DK0FR/Sciencedays2023/README.md

# Sciencedays2023

Project files for the Sciencedays 2023 Project: PCB Coil BLDC Motor.
