DK0FR/Sciencedays2023/PCBMotorV3/production_files/BOM.xlsx

Designator | Footprint | Quantity | Value | LCSC Part #
C10, C11, C12, C50, C6, C8, C9 | 0603 | 8 | 100n | C14663
J2 | USB_C_C2927293 | 1 |  | C2927293
Q10, Q11, Q13 | SOT-23 | 3 | AO3401A | C15127
R10, R100, R101, R102, R103, R104, R105, R11, R12, R13, R50 | 0603 | 9 | 10k | C25804
U2 | SSOP-10_3.9x4.9mm_P1.00mm_EP3x3mm | 1 | CH224K | C970725
U3 | LQFP-48_7x7mm_P0.5mm | 1 | STM32G030C8Tx | C529329
U5, U6, U7 | SOT-23W | 3 | CH941SR | C455292
D1, D2, D3 | LED_ASMB-KTF0-0A306 | 3 |  | C2874116
D4 | SOD123-W | 1 | B5819W SL | C8598
