DK0FR/Sciencedays2023/PCBMotorV3/production_files/BOM_Hand.xlsx

Designator | Footprint | Quantity | Value | Cost per piece | Total Cost
C1 | C_Disc_D7.5mm_W2.5mm_P5.00mm | 1 | 1u | 0.02 | 0.02 | https://de.aliexpress.com/item/1005004492291271.html?mp=1
C2, C3, C4 | C_Disc_D7.5mm_W2.5mm_P5.00mm | 3 | 10n | 0.02 | 0.06 | https://de.aliexpress.com/item/1005004492291271.html?mp=1
Q1, Q2, Q3, Q4, Q5, Q6 | TO-92 | 6 | 2N7000 | 0.04 | 0.24 | https://de.aliexpress.com/item/1005001859842797.html?curPageLogUid=THt7Ze4M6XRx
R1, R2, R3 | R_Axial_DIN0207_L6.3mm_D2.5mm_P12.5mm_Horizontal | 3 | 10k | 0.01 | 0.03 | https://de.aliexpress.com/item/1005002849812340.html?mp=1
R4, R5, R6 | R_Axial_DIN0207_L6.3mm_D2.5mm_P12.5mm_Horizontal | 3 | 5.1k | 0.01 | 0.03 | https://de.aliexpress.com/item/1005002849812340.html?mp=1
R7 | R_Axial_DIN0207_L6.3mm_D2.5mm_P12.5mm_Horizontal | 1 | 1k | 0.01 | 0.01 | https://de.aliexpress.com/item/1005002849812340.html?mp=1
U1 | TO-92 | 1 | AP7384-33V | 0.15 | 0.15 | https://de.aliexpress.com/item/1005004734295187.html?curPageLogUid=9FDWB8cPhNI2
 | Magnet | 8 |  | 0.05 | 0.4 | https://de.aliexpress.com/item/1005004052861676.html?mp=1
 | PCB Spacer | 4 |  | 0.14 | 0.56 | https://de.aliexpress.com/item/1005001458691986.html?curPageLogUid=zxzx5cIOwDQW
 |  |  |  | Total: | 1.5
