DK0FR/Sciencedays2023/CAD/Rotorv3.SLDPRT

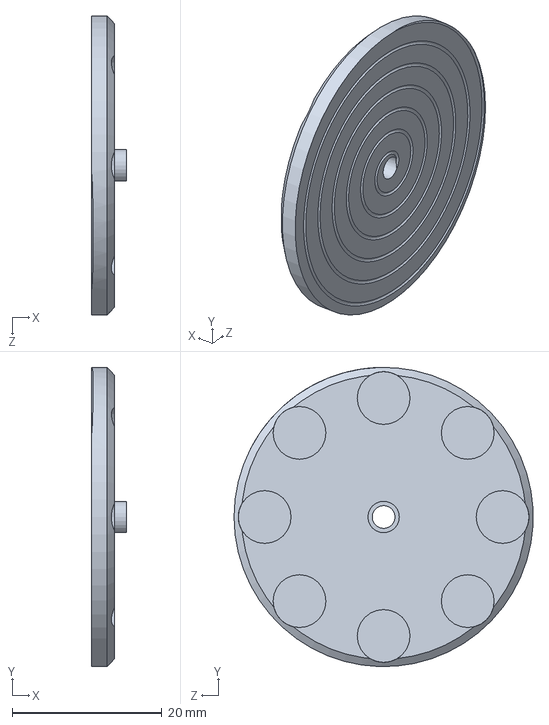
[picture p1: CAD file, 2023-10-25]
CAD/Rotorv3.SLDPRT
4.70 x 40.0 x 40.0 mm
