DK0FR/Sciencedays2023/PCBMotorV3/PCBMotorV3.step

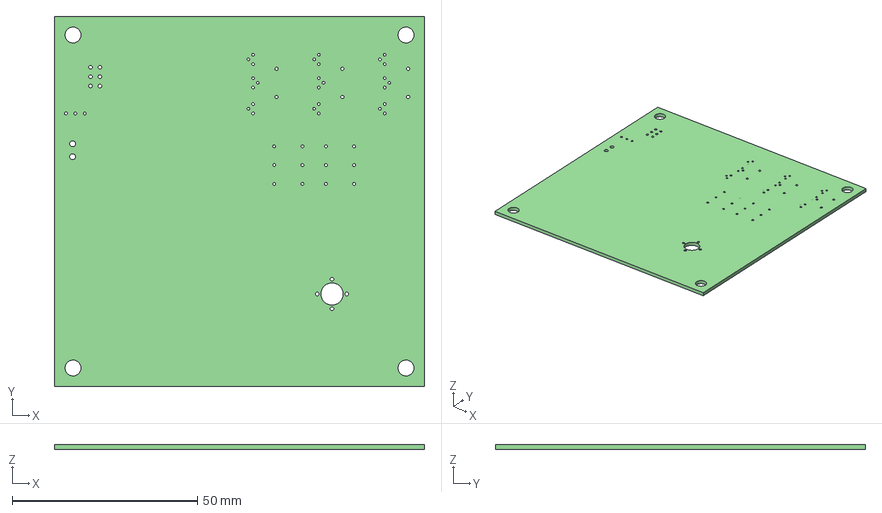
[picture p2: CAD file, 2023-10-25]
PCBMotorV3/PCBMotorV3.step
100.0 x 100.0 x 1.36 mm
