DK0FR/Sciencedays2023/CAD/KugellagerHalter.SLDPRT

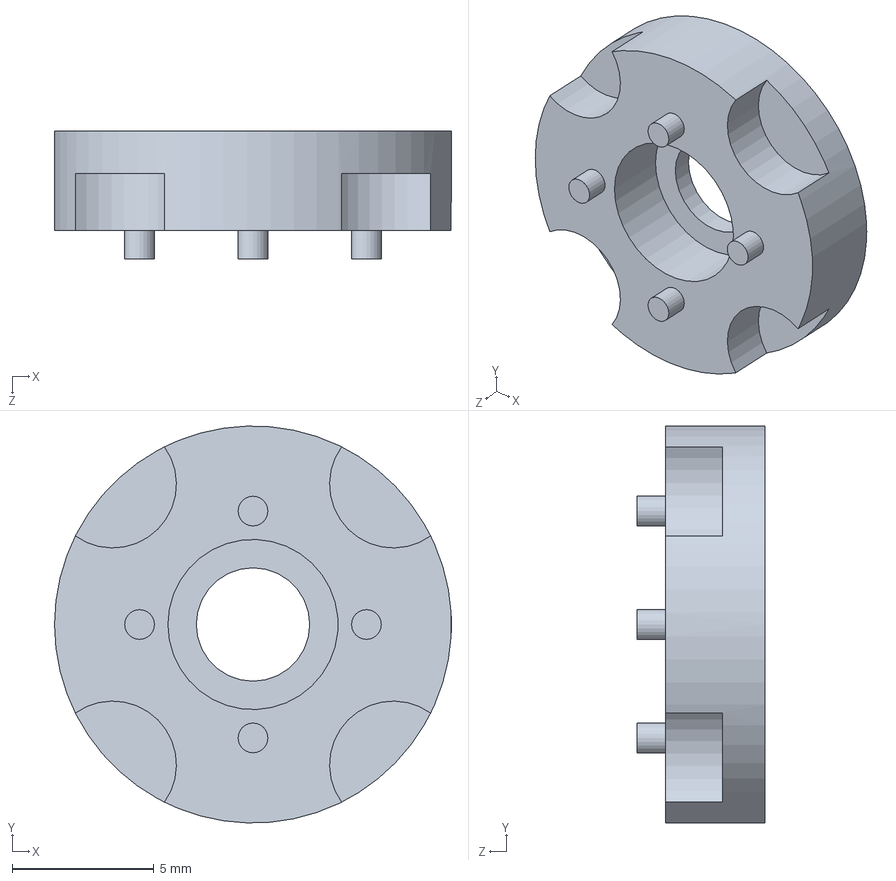
[picture p3: CAD file, 2023-10-25]
CAD/KugellagerHalter.SLDPRT
14.0 x 14.0 x 4.50 mm
