DK0FR/Sciencedays2023/(list of files, cad)

Other CAD files:
CAD/KugellagerHalter.STL
