DK0FR/Sciencedays2023/PCBMotorV3/PCBMotorV3.kicad_pcb

## KiCad design PCBMotorV3/PCBMotorV3.kicad_pcb (2023-10-25)

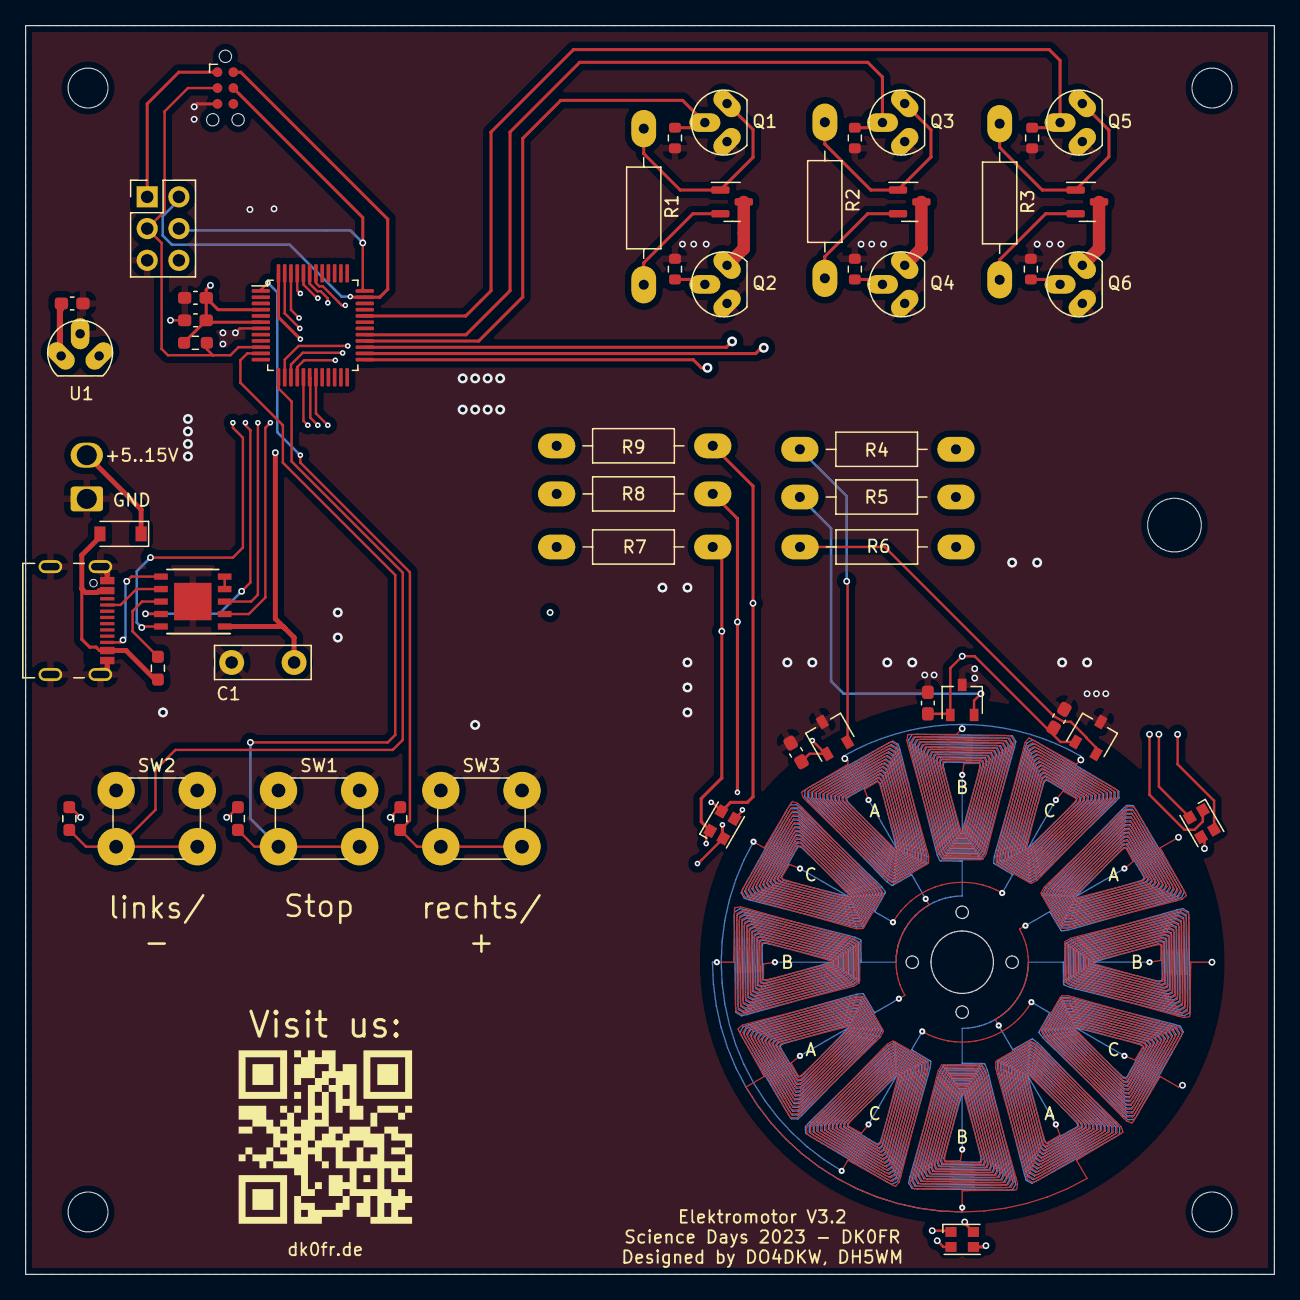
[picture p4: board PCBMotorV3.kicad_pcb from above]

Board: 4 copper layers, 100.0 x 100.0 mm, 58 parts (0 on the bottom side), 40 nets.

Parts:
C1: 1u; C_Disc_D7.5mm_W2.5mm_P5.00mm
C6, C8, C10, C11, C12, C50: 100n; C_0603_1608Metric_Pad1.08x0.95mm_HandSolder
D1, D2, D3: LED_RGBA; LED_ASMB-KTF0-0A306
D4: D; D_SOD-123
H1, H2, H3, H4: MountingHole; MountingHole_3.2mm_M3
H5: MountingHole; MountingHole_4.3mm_M4
J1: Conn_01x02; 2Pol_THT
J2: C2927293; USB_C_C2927293
J3: Conn_ARM_SWD_TagConnect_TC2030; Tag-Connect_TC2030-IDC-NL_2x03_P1.27mm_Vertical
Q1, Q2, Q3, Q4, Q5, Q6: 2N7000; TO-92
Q10, Q11, Q13: AO3401A; SOT-23
R1, R2, R3: 10k; R_Axial_DIN0207_L6.3mm_D2.5mm_P12.5mm_Horizontal
R4, R5, R6: 5.1k; R_Axial_DIN0207_L6.3mm_D2.5mm_P12.5mm_Horizontal
R7: 120; R_Axial_DIN0207_L6.3mm_D2.5mm_P12.5mm_Horizontal
R8: 56; R_Axial_DIN0207_L6.3mm_D2.5mm_P12.5mm_Horizontal
R9: 47; R_Axial_DIN0207_L6.3mm_D2.5mm_P12.5mm_Horizontal
R10, R11, R12, R13, R50: 10k; R_0603_1608Metric_Pad0.98x0.95mm_HandSolder
R100, R101, R102, R103, R104, R105: 10k; R_0603_1608Metric
SW1, SW2, SW3: SW_Push; SW_PUSH_6mm_H7.3mm
U1: AP7384-33V; TO-92
U2: CH224K; SSOP-10_3.9x4.9mm_P1.00mm_EP3x3mm
U3: STM32G030C8Tx; LQFP-48_7x7mm_P0.5mm
U4: DebugConn; PinHeader_2x03_P2.54mm_Vertical
U5, U6, U7: CH941SR; SOT-23W

Connections:
+3.3V: C1.2, C6.1, C8.1, C10.1, C11.1, C12.1, C50.1, J3.1 (VCC), R4.1, R5.1, R6.1, R10.1, R11.1, R12.1, R50.1, U1.1 (VO), U2.1 (VDD), U3.4 (VBAT), U3.6 (VDD), U4.1, U5.1 (VCC), U6.1 (VCC), U7.1 (VCC)
/PowerStage/Hall_U: R4.2, U3.14 (PA3), U5.2 (VOUT)
/PowerStage/Hall_V: R5.2, U3.15 (PA4), U6.2 (VOUT)
/PowerStage/Hall_W: R6.2, U3.16 (PA5), U7.2 (VOUT)
/PowerStage/U_H: Q1.2 (G), R100.2, U3.28 (PA8)
/PowerStage/U_L: Q2.2 (G), R101.2, U3.25 (PB13)
/PowerStage/V_H: Q3.2 (G), R102.2, U3.29 (PA9/NC)
/PowerStage/V_L: Q4.2 (G), R103.2, U3.26 (PB14)
/PowerStage/W_H: Q5.2 (G), R104.2, U3.32 (PA10/NC)
/PowerStage/W_L: Q6.2 (G), R105.2, U3.27 (PB15)
/coils: Q2.3 (D), Q4.3 (D), Q6.3 (D), Q10.3 (D), Q11.3 (D), Q13.3 (D)
/microcontroller/BTN_LEFT: R11.2, SW2.2, U3.13 (PA2)
/microcontroller/BTN_RIGHT: R12.2, SW3.2, U3.1 (PC13)
/microcontroller/BTN_STOP: R10.2, SW1.2, U3.11 (PA0)
/microcontroller/CFG1: U2.9 (CFG1), U3.44 (PB5)
/microcontroller/CFG2: U2.2 (CFG2), U3.42 (PB3)
/microcontroller/CFG3: U2.3 (CFG3), U3.43 (PB4)
/microcontroller/LED1: D1.3 (A), U3.17 (PA6)
/microcontroller/LED2: D2.3 (A), U3.18 (PA7)
/microcontroller/LED3: D3.3 (A), U3.19 (PB0)
/microcontroller/LED_B: R9.2, U3.48 (PB9)
/microcontroller/LED_G: R8.2, U3.47 (PB8)
/microcontroller/LED_R: R7.2, U3.46 (PB7)
/microcontroller/PG: U2.10 (PG), U3.45 (PB6)
GND: C1.1, C6.2, C8.2, C10.2, C11.2, C12.2, C50.2, J1.1, J2.A1 (GND), J2.A12 (GND), J2.B1 (GND), J2.B12 (GND), J2.S1 (SHIELD), J3.5 (GND), Q1.1 (S), Q2.1 (S), Q3.1 (S), Q4.1 (S), Q5.1 (S), Q6.1 (S), R100.1, R101.1, R102.1, R103.1, R104.1, R105.1, SW1.1, SW2.1, SW3.1, U1.2 (GND), U2.11 (GND), U3.7 (VSS), U4.5, U5.3 (GND), U6.3 (GND), U7.3 (GND)
NRST: J3.3 (~RESET), R50.2, U3.10 (NRST), U4.3
unnamed: D1.1 (RK), D2.1 (RK), D3.1 (RK), R7.1
unnamed: D1.2 (BL), D2.2 (BL), D3.2 (BL), R8.1
unnamed: D1.4 (GR), D2.4 (GR), D3.4 (GR), R9.1
unnamed: D4.2 (A), J2.A4 (VBUS), J2.A9 (VBUS), J2.B4 (VBUS), J2.B9 (VBUS), R13.1
unnamed: J2.A5 (CC1), U2.7 (CC1)
unnamed: J2.B5 (CC2), U2.6 (CC2)
unnamed: Q1.3 (D), Q10.1 (G), R1.1
unnamed: Q3.3 (D), Q11.1 (G), R2.1
unnamed: Q5.3 (D), Q13.1 (G), R3.1
unnamed: R13.2, U2.8 (VBUS)
unnamed: U2.4 (DP), U2.5 (DM)
SWCLK: J3.4 (SWCLK), U3.36 (PA14), U4.4
SWDIO: J3.2 (SWDIO), U3.35 (PA13), U4.2
VCC: D4.1 (K), J1.2, Q10.2 (S), Q11.2 (S), Q13.2 (S), R1.2, R2.2, R3.2, U1.3 (VI)
