DK0FR/Sciencedays2023/CodeV2/CodeV2.ioc

Mcu.UserName=STM32G030C8Tx
PA0.GPIO_Label=STOP
PA0.Signal=GPIO_Input
PA10.Signal=S_TIM1_CH3
PA13.Signal=SYS_SWDIO
PA14-BOOT0.Signal=SYS_SWCLK
PA2.GPIO_Label=LEFT
PA2.Signal=GPIO_Input
PA3.GPIO_Label=HALL_U
PA3.Signal=GPXTI3
PA4.GPIO_Label=HALL_V
PA4.Signal=GPXTI4
PA5.GPIO_Label=HALL_W
PA5.Signal=GPIO_Input
PA6.GPIO_Label=LED1
PA6.Signal=GPIO_Output
PA7.GPIO_Label=LED2
PA7.Signal=GPIO_Output
PA8.Signal=S_TIM1_CH1
PA9.Signal=S_TIM1_CH2
PB0.GPIO_Label=LED3
PB0.Signal=GPIO_Output
PB13.Signal=TIM1_CH1N
PB14.Signal=TIM1_CH2N
PB15.Signal=TIM1_CH3N
PB3.GPIO_Label=CFG2
PB3.Signal=GPIO_Output
PB4.GPIO_Label=CFG3
PB4.Signal=GPIO_Output
PB5.GPIO_Label=CFG1
PB5.Signal=GPIO_Output
PB6.GPIO_Label=PG
PB6.Signal=GPIO_Input
PB7.GPIO_Label=LED_R
PB7.Signal=GPIO_Output
PB8.GPIO_Label=LED_G
PB8.Signal=GPIO_Output
PB9.GPIO_Label=LED_B
PB9.Signal=GPIO_Output
PC13.GPIO_Label=RIGHT
PC13.Signal=GPIO_Input
