DK0FR/Sciencedays2023/CodeV2/Core/Inc/main.h

#define RIGHT_Pin GPIO_PIN_13
#define RIGHT_GPIO_Port GPIOC
#define STOP_Pin GPIO_PIN_0
#define STOP_GPIO_Port GPIOA
#define LEFT_Pin GPIO_PIN_2
#define LEFT_GPIO_Port GPIOA
#define HALL_U_Pin GPIO_PIN_3
#define HALL_U_GPIO_Port GPIOA
#define HALL_V_Pin GPIO_PIN_4
#define HALL_V_GPIO_Port GPIOA
#define HALL_W_Pin GPIO_PIN_5
#define HALL_W_GPIO_Port GPIOA
#define LED1_Pin GPIO_PIN_6
#define LED1_GPIO_Port GPIOA
#define LED2_Pin GPIO_PIN_7
#define LED2_GPIO_Port GPIOA
#define LED3_Pin GPIO_PIN_0
#define LED3_GPIO_Port GPIOB
#define CFG2_Pin GPIO_PIN_3
#define CFG2_GPIO_Port GPIOB
#define CFG3_Pin GPIO_PIN_4
#define CFG3_GPIO_Port GPIOB
#define CFG1_Pin GPIO_PIN_5
#define CFG1_GPIO_Port GPIOB
#define PG_Pin GPIO_PIN_6
#define PG_GPIO_Port GPIOB
#define LED_R_Pin GPIO_PIN_7
#define LED_R_GPIO_Port GPIOB
#define LED_G_Pin GPIO_PIN_8
#define LED_G_GPIO_Port GPIOB
#define LED_B_Pin GPIO_PIN_9
#define LED_B_GPIO_Port GPIOB
